YeQi17C/material-design/(list of files, cad)

Other CAD files:
低速大齿轮(A3 1：1.5).dwg
装配图(A0 1：1).dwg
输出轴(A3 1：1).dwg
